OxyMagnesium/pal-9k22/symbols/PKM13EPYH4000-A0.step

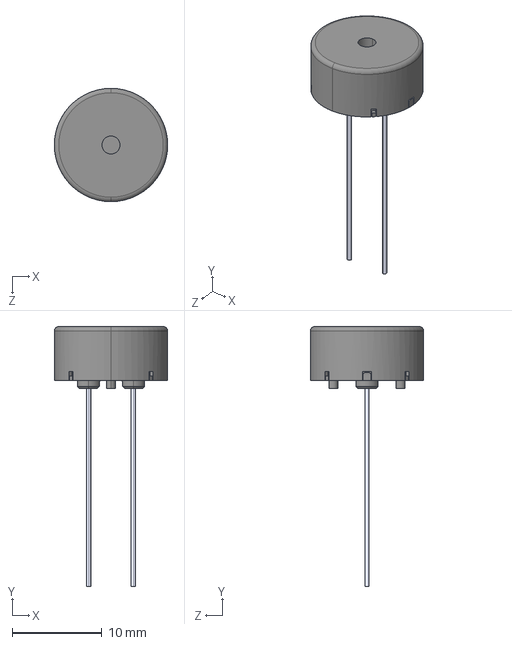
[picture p1: CAD file, 2023-06-02]
symbols/PKM13EPYH4000-A0.step
12.6 x 28.9 x 12.6 mm
