OxyMagnesium/pal-9k22/footprints/footprints.models/ICM-20689.step

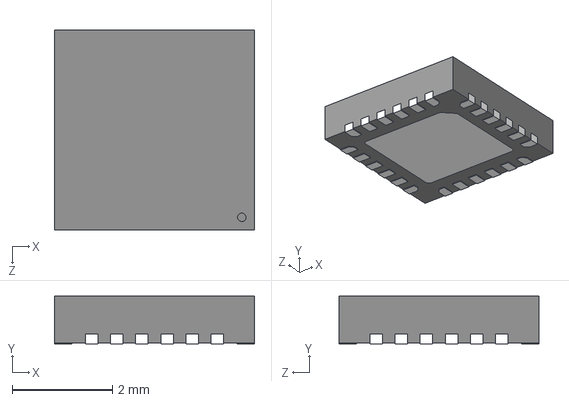
[picture p2: CAD file, 2023-06-02]
footprints/footprints.models/ICM-20689.step
4.00 x 0.95 x 4.00 mm
