OxyMagnesium/pal-9k22/symbols/EMMC04G-M627-A01.step

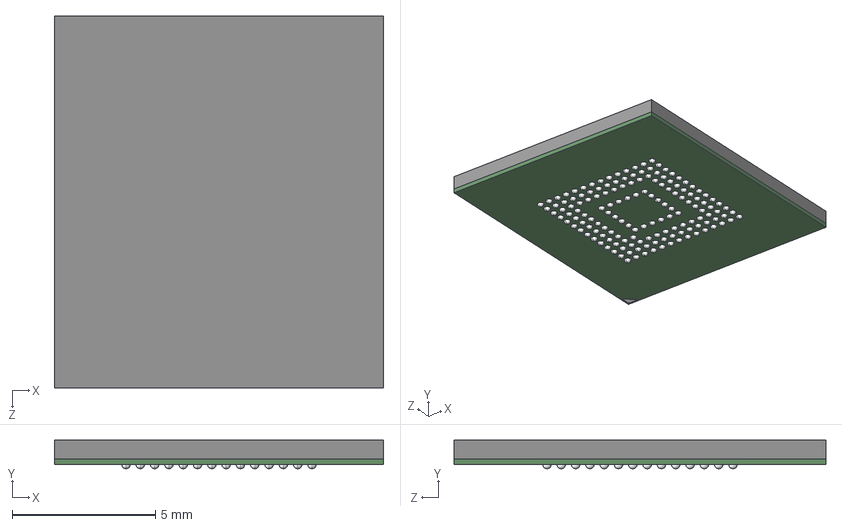
[picture p3: CAD file, 2023-06-02]
symbols/EMMC04G-M627-A01.step
11.5 x 1.00 x 13.0 mm
