OxyMagnesium/pal-9k22/footprints/footprints.models/AT25QF641B-MHB-T.step

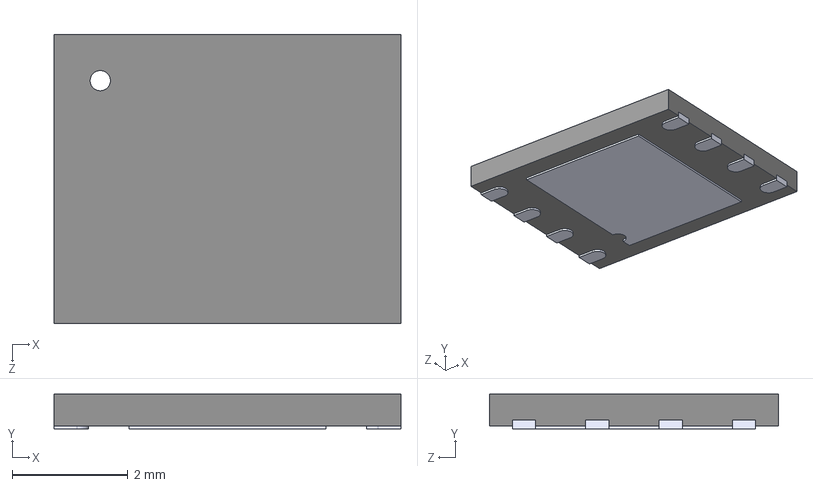
[picture p4: CAD file, 2023-06-02]
footprints/footprints.models/AT25QF641B-MHB-T.step
6.00 x 0.6 x 5.00 mm
