OxyMagnesium/pal-9k22/footprints/footprints.models/CPC1125N_IXY.step

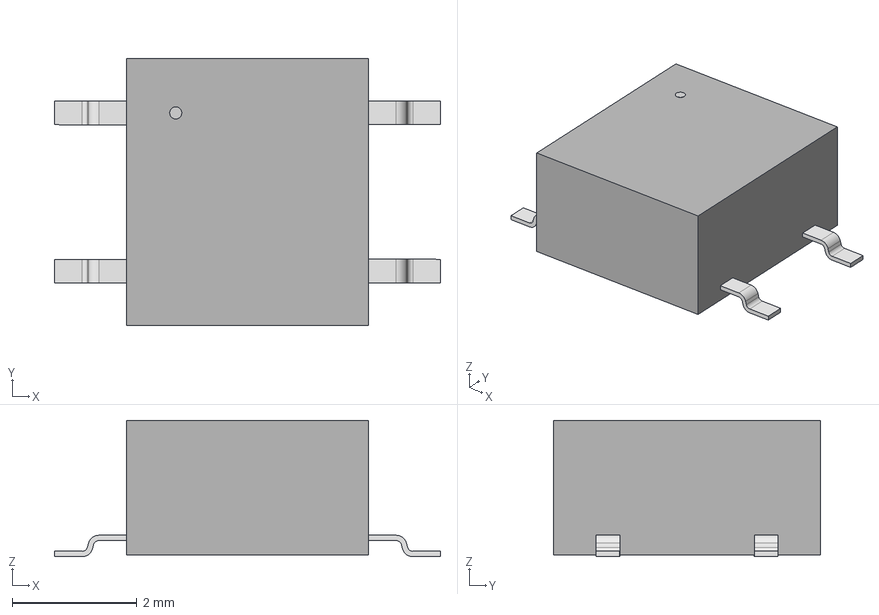
[picture p5: CAD file, 2023-06-02]
footprints/footprints.models/CPC1125N_IXY.step
6.20 x 4.29 x 2.19 mm
