OxyMagnesium/pal-9k22/footprints/footprints.models/MS560702BA03-50.step

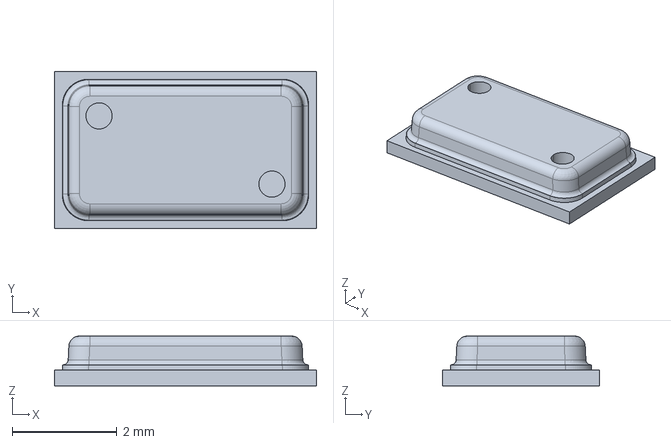
[picture p6: CAD file, 2023-06-02]
footprints/footprints.models/MS560702BA03-50.step
5.00 x 3.00 x 0.95 mm
