OxyMagnesium/pal-9k22/avionics.kicad_pcb

## KiCad design avionics.kicad_pcb (2023-06-02)

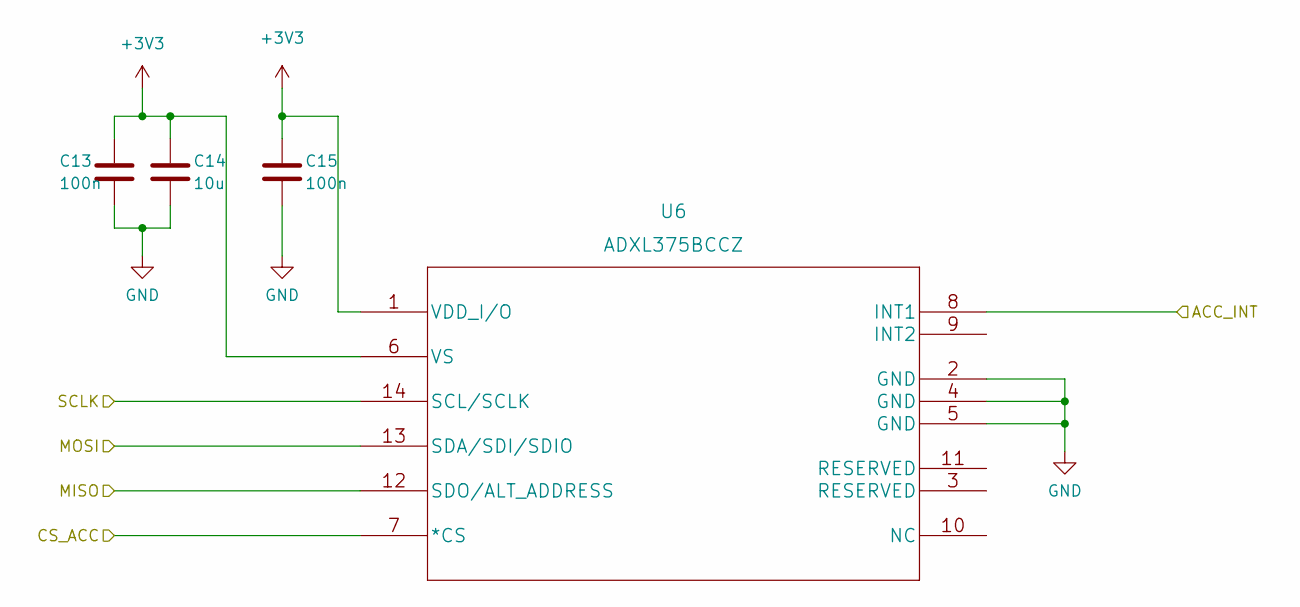
[picture p7: schematic accelerometer.kicad_sch, PAL 9000]

Parts:
C13, C15: 100n; C_0603_1608Metric
C14: 10u; C_0603_1608Metric
U6: ADXL375BCCZ; LGA-14_3x5mm_P0.8mm_LayoutBorder1x6y

Connections:
+3V3: C13.1, C14.1, C15.1, U6.1 (VDD_I/O), U6.6 (VS); also elsewhere on the board
/Accelerometer/ACC_INT: U6.8 (INT1); also elsewhere on the board
/Accelerometer/CS_ACC: U6.7 (*CS); also elsewhere on the board
/Accelerometer/MISO: U6.12 (SDO/ALT_ADDRESS); also elsewhere on the board
/Accelerometer/MOSI: U6.13 (SDA/SDI/SDIO); also elsewhere on the board
/Accelerometer/SCLK: U6.14 (SCL/SCLK); also elsewhere on the board
GND: C13.2, C14.2, C15.2, U6.2 (GND), U6.4 (GND), U6.5 (GND); also elsewhere on the board

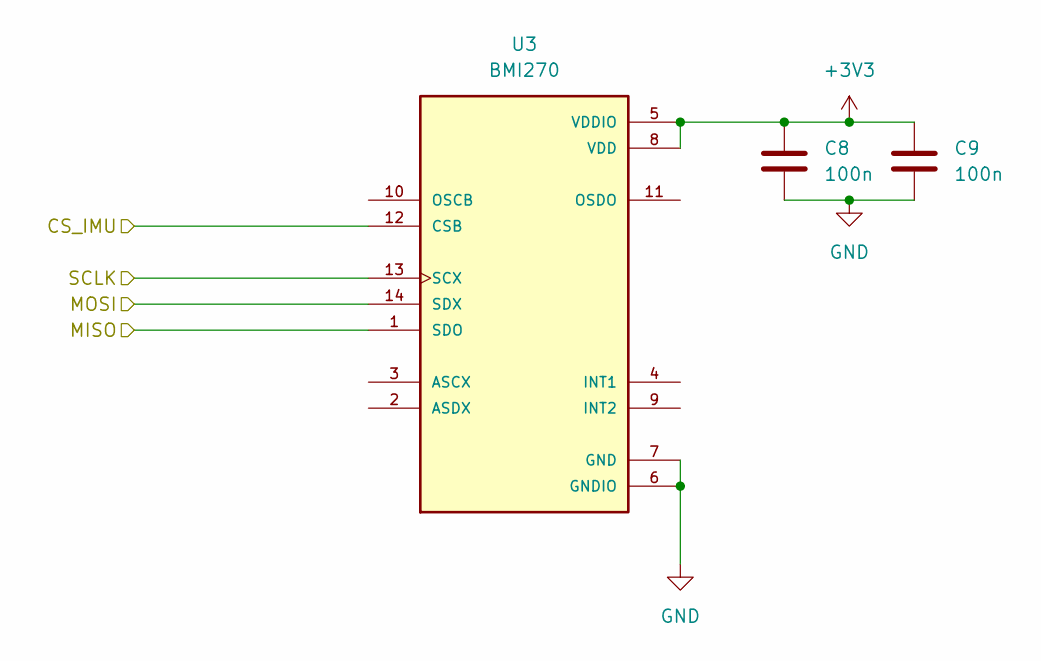
[picture p8: schematic imu.kicad_sch, PAL 9000]

Parts:
C8, C9: 100n; C_0603_1608Metric
U3: BMI270; XDCR_BMI270

Connections:
+3V3: C8.1, C9.1, U3.5 (VDDIO), U3.8 (VDD); also elsewhere on the board
/Accelerometer/MISO: U3.1 (SDO); also elsewhere on the board
/Accelerometer/MOSI: U3.14 (SDX); also elsewhere on the board
/Accelerometer/SCLK: U3.13 (SCX); also elsewhere on the board
/IMU/CS_IMU: U3.12 (CSB); also elsewhere on the board
GND: C8.2, C9.2, U3.6 (GNDIO), U3.7 (GND); also elsewhere on the board

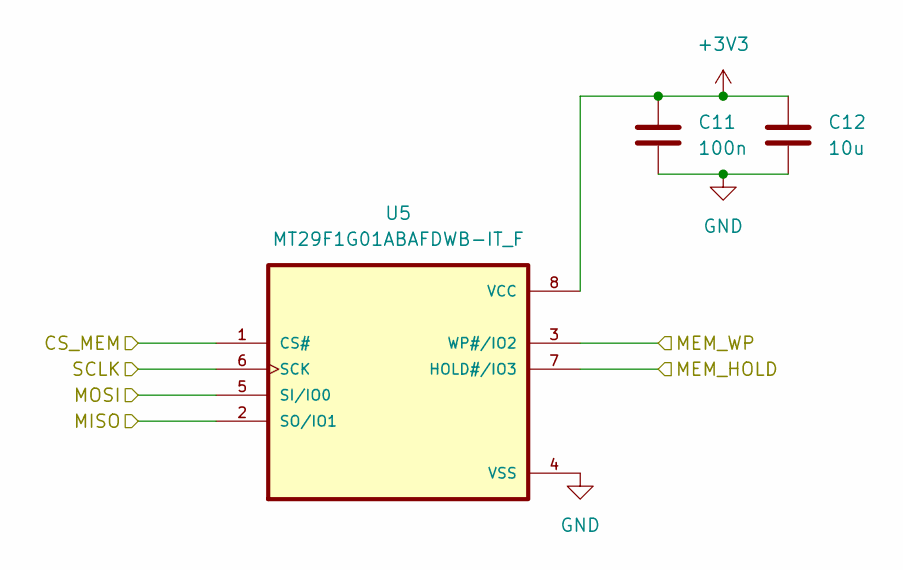
[picture p9: schematic memory.kicad_sch, PAL 9000]

Parts:
C11: 100n; C_0603_1608Metric
C12: 10u; C_0603_1608Metric
U5: MT29F1G01ABAFDWB-IT_F; SON127P600X800X65-8N; PARTREV LTR

Connections:
+3V3: C11.1, C12.1, U5.8 (VCC); also elsewhere on the board
/Accelerometer/MISO: U5.2 (SO/IO1); also elsewhere on the board
/Accelerometer/MOSI: U5.5 (SI/IO0); also elsewhere on the board
/Accelerometer/SCLK: U5.6 (SCK); also elsewhere on the board
/MCU/CS_MEM: U5.1 (CS#); also elsewhere on the board
/MCU/MEM_HOLD: U5.7 (HOLD#/IO3); also elsewhere on the board
/MCU/MEM_WP: U5.3 (WP#/IO2); also elsewhere on the board
GND: C11.2, C12.2, U5.4 (VSS); also elsewhere on the board

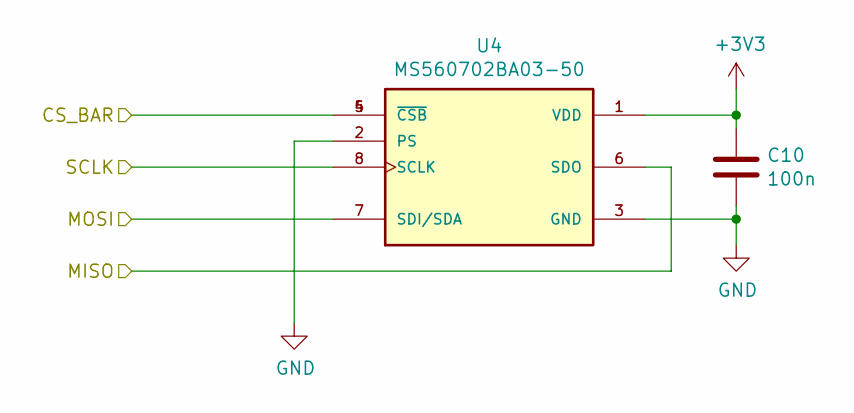
[picture p10: schematic barometer.kicad_sch, PAL 9000]

Parts:
C10: 100n; C_0603_1608Metric
U4: MS560702BA03-50; SON125P300X500X100-8N

Connections:
+3V3: C10.1, U4.1 (VDD); also elsewhere on the board
/Accelerometer/MISO: U4.6 (SDO); also elsewhere on the board
/Accelerometer/MOSI: U4.7 (SDI/SDA); also elsewhere on the board
/Accelerometer/SCLK: U4.8 (SCLK); also elsewhere on the board
/Barometer/CS_BAR: U4.4 (~CSB), U4.5 (~CSB); also elsewhere on the board
GND: C10.2, U4.2 (PS), U4.3 (GND); also elsewhere on the board

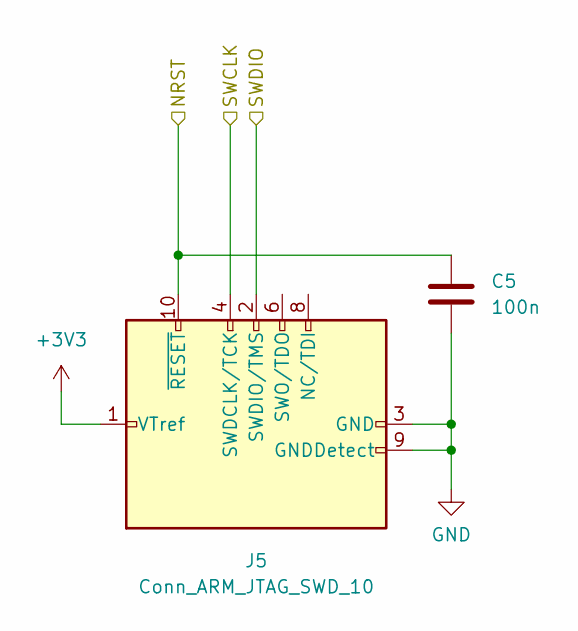
[picture p11: schematic debug.kicad_sch, PAL 9000]

Parts:
C5: 100n; C_0603_1608Metric
J5: Conn_ARM_JTAG_SWD_10; ARM-JTAG-10-SWD-IDC

Connections:
+3V3: J5.1 (VTref); also elsewhere on the board
/Debug/NRST: C5.1, J5.10 (~RESET); also elsewhere on the board
/Debug/SWCLK: J5.4 (SWDCLK/TCK); also elsewhere on the board
/Debug/SWDIO: J5.2 (SWDIO/TMS); also elsewhere on the board
GND: C5.2, J5.3 (GND), J5.5 (GND), J5.9 (GNDDetect); also elsewhere on the board

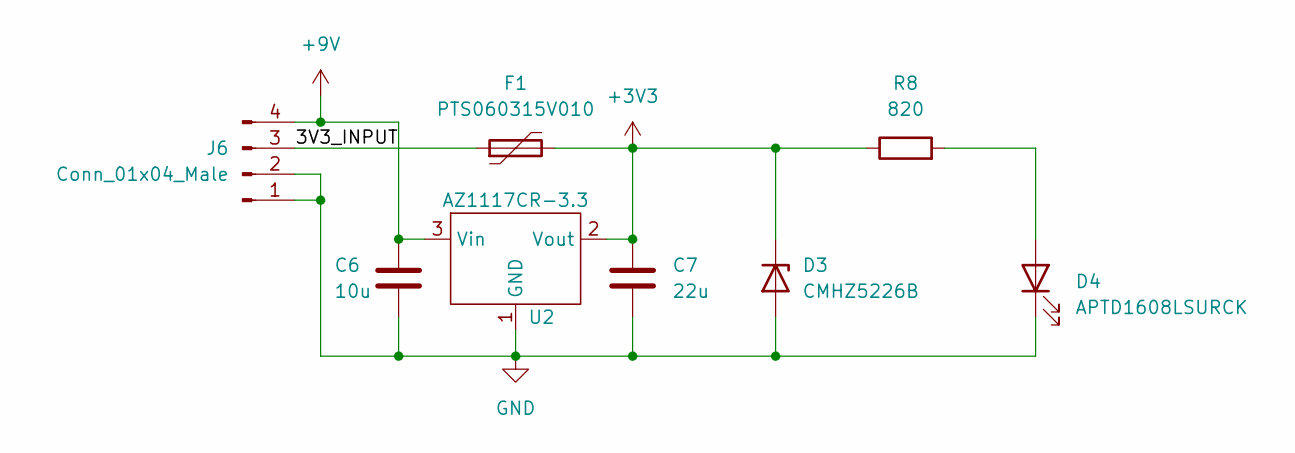
[picture p12: schematic power.kicad_sch, PAL 9000]

Parts:
C6: 10u; C_0603_1608Metric
C7: 22u; C_0603_1608Metric
D3: CMHZ5226B; D_SOD-123
D4: APTD1608LSURCK; LED_0603_1608Metric
F1: PTS060315V010; Fuse_0603_1608Metric
J6: Conn_01x04_Male; PinHeader_1x04_P2.54mm_Vertical
R8: 820; R_0603_1608Metric
U2: AZ1117CR-3.3; SOT-89-3

Connections:
+3V3: C7.1, D3.1 (K), F1.2, R8.1, U2.2 (Vout); also elsewhere on the board
+9V: C6.1, J6.4, U2.3 (Vin); also elsewhere on the board
/Power/3V3_INPUT: F1.1, J6.3
GND: C6.2, C7.2, D3.2 (A), D4.1 (K), J6.1, J6.2, U2.1 (GND); also elsewhere on the board
unnamed: D4.2 (A), R8.2

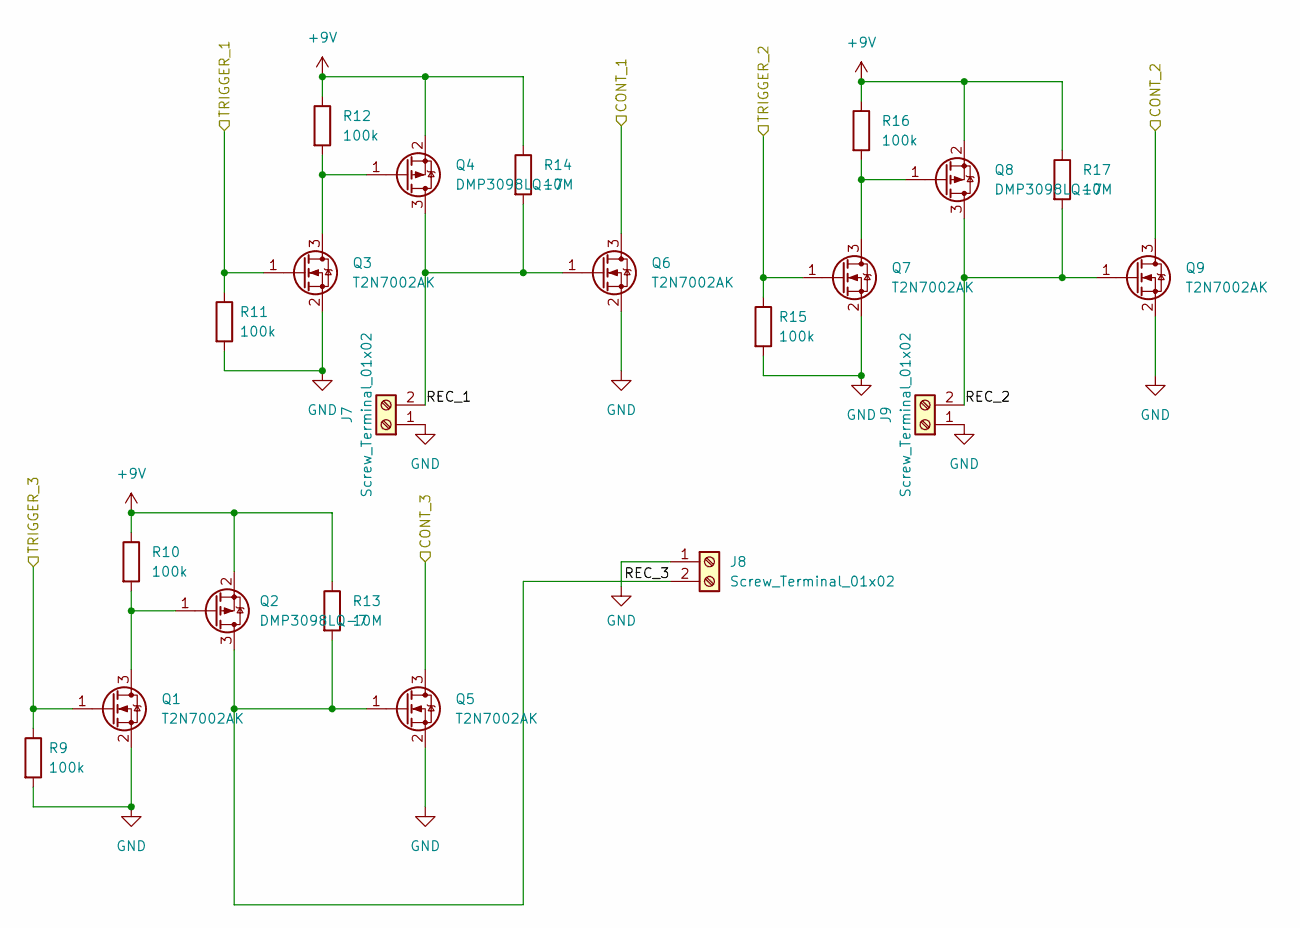
[picture p13: schematic relays.kicad_sch, PAL 9000]

Parts:
J7, J8, J9: Screw_Terminal_01x02; PinHeader_1x02_P2.54mm_Vertical
Q1, Q3, Q5, Q6, Q7, Q9: T2N7002AK; SOT-23
Q2, Q4, Q8: DMP3098LQ-7; SOT-23
R9, R10, R11, R12, R15, R16: 100k; R_0603_1608Metric
R13, R14, R17: 10M; R_0603_1608Metric

Connections:
+9V: Q2.2 (S), Q4.2 (S), Q8.2 (S), R10.1, R12.1, R13.1, R14.1, R16.1, R17.1; also elsewhere on the board
/MCU/CONT_1: Q6.3 (D); also elsewhere on the board
/MCU/CONT_2: Q9.3 (D); also elsewhere on the board
/MCU/CONT_3: Q5.3 (D); also elsewhere on the board
/MCU/TRIGGER_1: Q3.1 (G), R11.1; also elsewhere on the board
/MCU/TRIGGER_2: Q7.1 (G), R15.1; also elsewhere on the board
/MCU/TRIGGER_3: Q1.1 (G), R9.1; also elsewhere on the board
/Relays/REC_1: J7.2, Q4.3 (D), Q6.1 (G), R14.2
/Relays/REC_2: J9.2, Q8.3 (D), Q9.1 (G), R17.2
/Relays/REC_3: J8.2, Q2.3 (D), Q5.1 (G), R13.2
GND: J7.1, J8.1, J9.1, Q1.2 (S), Q3.2 (S), Q5.2 (S), Q6.2 (S), Q7.2 (S), Q9.2 (S), R9.2, R11.2, R15.2; also elsewhere on the board
unnamed: Q1.3 (D), Q2.1 (G), R10.2
unnamed: Q3.3 (D), Q4.1 (G), R12.2
unnamed: Q7.3 (D), Q8.1 (G), R16.2

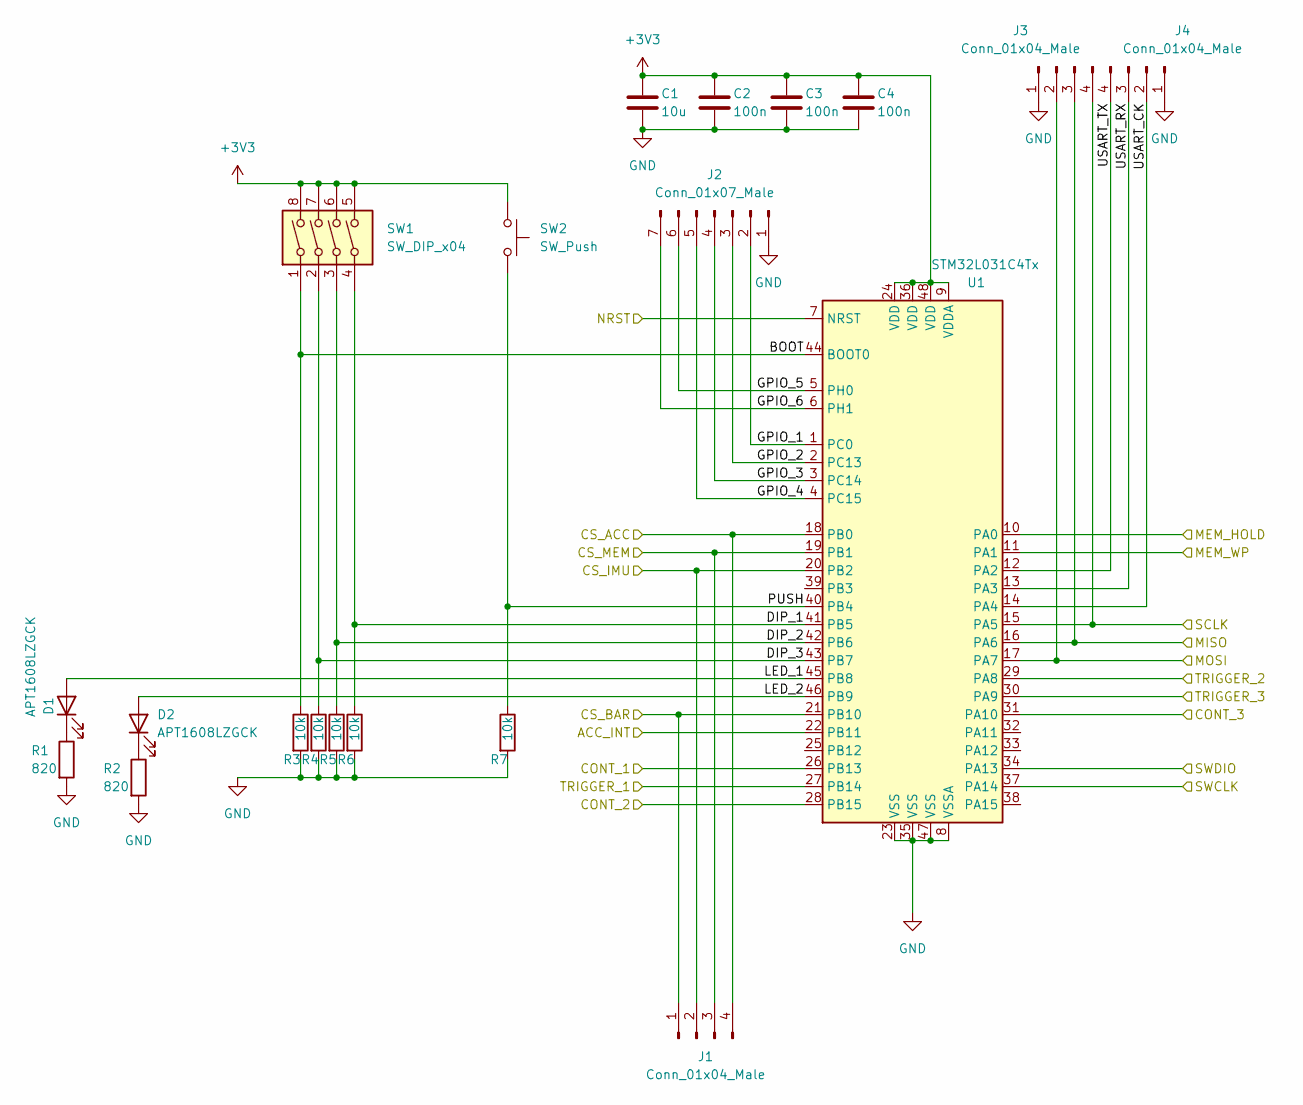
[picture p14: schematic mcu.kicad_sch, PAL 9000]

Parts:
C1: 10u; C_0603_1608Metric
C2, C3, C4: 100n; C_0603_1608Metric
D1, D2: APT1608LZGCK; LED_0603_1608Metric
J1, J3, J4: Conn_01x04_Male; PinHeader_1x04_P2.54mm_Vertical
J2: Conn_01x07_Male; PinHeader_1x07_P2.54mm_Vertical
R1, R2: 820; R_0603_1608Metric
R3, R4, R5, R6, R7: 10k; R_0603_1608Metric
SW1: SW_DIP_x04; SW_DIP_SPSTx04_Slide_Omron_A6S-410x_W8.9mm_P2.54mm
SW2: SW_Push; SW_Push_1P1T_NO_CK_KSC7xxJ
U1: STM32L031C4Tx; LQFP-48_7x7mm_P0.5mm

Connections:
+3V3: C1.1, C2.1, C3.1, C4.1, SW1.5, SW1.6, SW1.7, SW1.8, SW2.1, U1.9 (VDDA), U1.24 (VDD), U1.36 (VDD), U1.48 (VDD); also elsewhere on the board
/Accelerometer/ACC_INT: U1.22 (PB11); also elsewhere on the board
/Accelerometer/CS_ACC: J1.4, U1.18 (PB0); also elsewhere on the board
/Accelerometer/MISO: J3.3, U1.16 (PA6); also elsewhere on the board
/Accelerometer/MOSI: J3.2, U1.17 (PA7); also elsewhere on the board
/Accelerometer/SCLK: J3.4, U1.15 (PA5); also elsewhere on the board
/Barometer/CS_BAR: J1.1, U1.21 (PB10); also elsewhere on the board
/Debug/NRST: U1.7 (NRST); also elsewhere on the board
/Debug/SWCLK: U1.37 (PA14); also elsewhere on the board
/Debug/SWDIO: U1.34 (PA13); also elsewhere on the board
/IMU/CS_IMU: J1.2, U1.20 (PB2); also elsewhere on the board
/MCU/BOOT: R3.1, SW1.1, U1.44 (BOOT0)
/MCU/CONT_1: U1.26 (PB13); also elsewhere on the board
/MCU/CONT_2: U1.28 (PB15); also elsewhere on the board
/MCU/CONT_3: U1.31 (PA10); also elsewhere on the board
/MCU/CS_MEM: J1.3, U1.19 (PB1); also elsewhere on the board
/MCU/DIP_1: R6.1, SW1.4, U1.41 (PB5)
/MCU/DIP_2: R5.1, SW1.3, U1.42 (PB6)
/MCU/DIP_3: R4.1, SW1.2, U1.43 (PB7)
/MCU/GPIO_1: J2.2, U1.1 (PC0)
/MCU/GPIO_2: J2.3, U1.2 (PC13)
/MCU/GPIO_3: J2.4, U1.3 (PC14)
/MCU/GPIO_4: J2.5, U1.4 (PC15)
/MCU/GPIO_5: J2.6, U1.5 (PH0)
/MCU/GPIO_6: J2.7, U1.6 (PH1)
/MCU/LED_1: D1.2 (A), U1.45 (PB8)
/MCU/LED_2: D2.2 (A), U1.46 (PB9)
/MCU/MEM_HOLD: U1.10 (PA0); also elsewhere on the board
/MCU/MEM_WP: U1.11 (PA1); also elsewhere on the board
/MCU/PUSH: R7.1, SW2.2, U1.40 (PB4)
/MCU/TRIGGER_1: U1.27 (PB14); also elsewhere on the board
/MCU/TRIGGER_2: U1.29 (PA8); also elsewhere on the board
/MCU/TRIGGER_3: U1.30 (PA9); also elsewhere on the board
/MCU/USART_CK: J4.2, U1.14 (PA4)
/MCU/USART_RX: J4.3, U1.13 (PA3)
/MCU/USART_TX: J4.4, U1.12 (PA2)
GND: C1.2, C2.2, C3.2, C4.2, J2.1, J3.1, J4.1, R1.2, R2.2, R3.2, R4.2, R5.2, R6.2, R7.2, U1.8 (VSSA), U1.23 (VSS), U1.35 (VSS), U1.47 (VSS); also elsewhere on the board
unnamed: D1.1 (K), R1.1
unnamed: D2.1 (K), R2.1

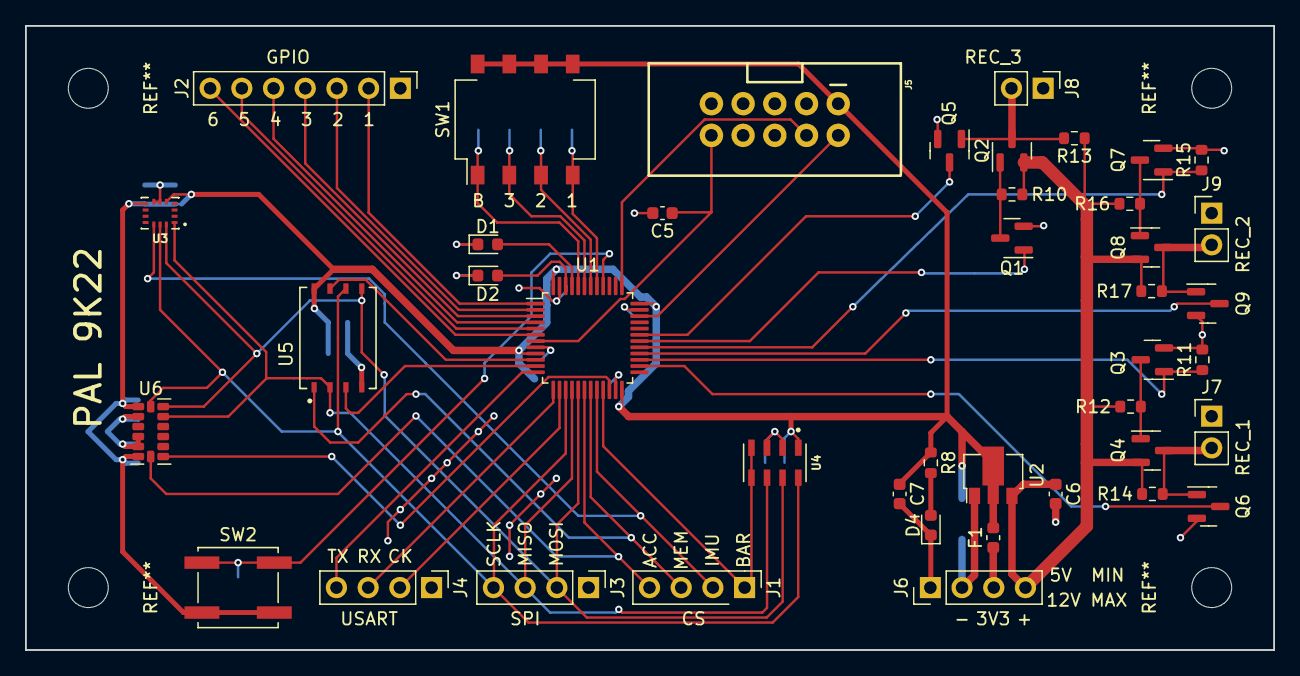
[picture p15: board avionics.kicad_pcb from above]

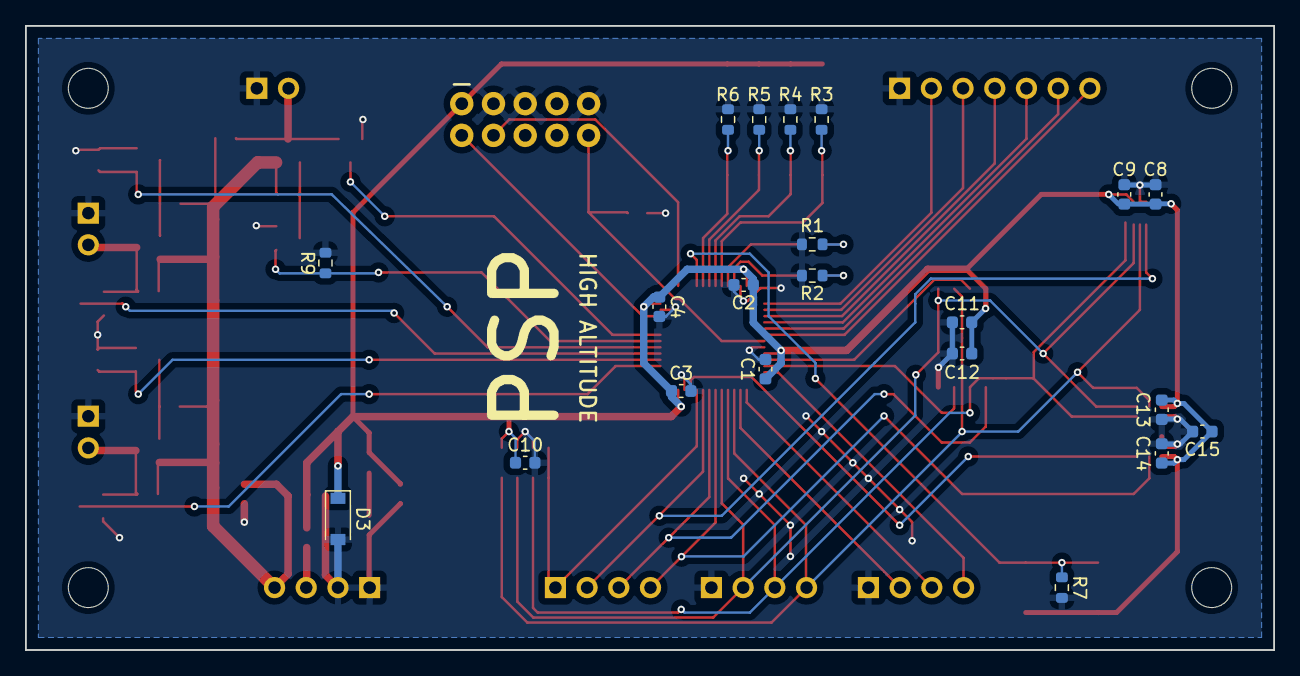
[picture p16: board avionics.kicad_pcb from below]

Board: 2 copper layers, 100.0 x 50.0 mm, 63 parts (21 on the bottom side), 48 nets.
